slave2thegrind84/Danfoss_101N0500_Aduino/images/Running.jpeg

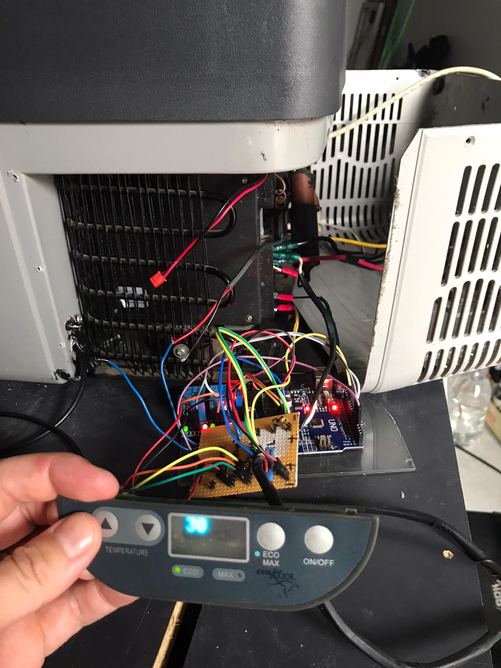
images/Running.jpeg
