slave2thegrind84/Danfoss_101N0500_Aduino/(commit log)

2024-03-07 Added photo of interface to danfoss motor
2024-03-07 added danfos schematic
2024-03-07 added link to danfoss wiring diagram
2024-03-07 added harness wiring details
2024-03-07 added schematics
2024-03-07 added schematic for user control
2024-03-07 added user control schematic to readme
2024-03-07 added label to user control schematic
2024-03-07 Added mainboard schematic
2024-03-07 updated mainboard schematic
2024-03-07 added voltage stepdown
